lrrosa/retrosc-pong/docs/schematic.md

# Esquemático

Diagramas por **bloco funcional** (SVG), com as referências (R1, C2, J4…) que
aparecem na [lista de materiais](bom.md) e na serigrafia da placa.

> **Só quer montar?** A **PCB já está pronta** em [kicad/](../kicad/README.md)
> — baixe o ZIP de gerbers e mande fabricar. Este documento serve para
> entender cada bloco, montar em placa universal, ou modificar o projeto.

**Esquemático completo em uma folha** (gerado do KiCad, com todas as
referências e valores):
[PDF da variante oficial](retrosc-pong-esquematico.pdf) ·
[PDF da variante roxa de 1 botão](retrosc-pong-yd-esquematico.pdf) ·
[SVG](images/kicad/retrosc-pong.svg)

Mapa de pinos usados

> ⚠️ **Os números de pino deste documento são as posições do Pico oficial**
> (valem também para a YD-RP2040 de 3 botões). A **roxa de 1 botão** usa
> outras posições — confira em [pinout.md](pinout.md) antes de ligar os fios.
> Coincidem nas três: **p36** (3V3), **p38** (GND), **p39** (VSYS/VIN) e
> **p40** (+5 V). Mudam, entre outros: GP16/17/18, GP22, GP26/27 e o **AGND**
> (p33 no Pico, **p29** na roxa).

## DAC de vídeo composto (2 resistores)

DAC de vídeo composto de 2 resistores

Combina os 2 pinos GPIO num sinal de 3 níveis lido pela TV:

| GP16 (SYNC) | GP17 (VIDEO) | Tensão na TV (75 Ω carga) | Significado |
| :---: | :---: | :---: | --- |
| 0 | 0 | 0,00 V | Sync tip |
| 1 | 0 | ~0,37 V | Black (blanking) |
| 1 | 1 | ~1,00 V | White |
| 0 | 1 | (não usado) | - |

Cálculo (Thevenin, 3,3 V, R1=470, R2=270, term=75):

```
G = 1/470 + 1/270 + 1/75 = 0,01916 S
V_black = (3.3/470) / G = 0,366 V
V_white = (3.3/470 + 3.3/270) / G = 1,004 V
```

> **Por que 270 Ω (e não 220 Ω)?** Com 220 Ω o branco fica em ~1,10 V — um
> pouco "quente" acima do 1,00 V padrão. Com 270 Ω o branco cai exatamente em
> ~1,00 V; **testado na TV real, a imagem fica visivelmente melhor**. (1 kΩ +
> 470 Ω também funciona, mas o branco despenca para ~0,63 V — imagem escura.)

### Impedância de saída do GPIO (drive strength)

O cálculo acima assume uma fonte ideal de 3,3 V. Na prática, cada pino GPIO do
RP2040 tem uma impedância de saída em série que se soma a R1/R2 e **abaixa**
os níveis (o branco fica abaixo do calculado). No default (drive de 4 mA) essa
impedância é de ~40–50 Ω; o projeto [obstruse/pico-composite8](https://github.com/obstruse/pico-composite8)
mediu ~40 Ω e teve que compensar nos resistores do seu DAC R2R de 8 bits.

No nosso DAC de 3 níveis isso é menos crítico (a TV tolera bem a faixa), mas
em `src/ntsc.c` configuramos os pinos de vídeo para **drive de 12 mA com slew
rate rápido**, o que reduz a impedância de saída, aproxima os níveis do
calculado e deixa preto/branco mais consistentes:

```c
gpio_set_drive_strength(NTSC_SYNC_PIN,  GPIO_DRIVE_STRENGTH_12MA);
gpio_set_drive_strength(NTSC_VIDEO_PIN, GPIO_DRIVE_STRENGTH_12MA);
gpio_set_slew_rate(NTSC_SYNC_PIN,  GPIO_SLEW_RATE_FAST);
gpio_set_slew_rate(NTSC_VIDEO_PIN, GPIO_SLEW_RATE_FAST);
```

> O próprio **R2 = 270 Ω saiu dessa calibração**: partimos de 220 Ω (branco
> teórico 1,10 V) e o teste na TV real mostrou imagem melhor com 270 Ω
> (branco ~1,00 V). Se quiser refinar mais, meça o branco com a TV conectada
> (carga de 75 Ω) e ajuste R2 até ~1,0 V.

O datasheet do RP2040 (seção 5.5.3.5) confirma essa abordagem: "quanto maior o
drive strength, mais próxima a tensão de saída fica de IOVDD para uma dada
corrente". Dois números úteis dele para este DAC:

- **Margem de corrente:** o limite do banco de IO é `I_IOVDD_MAX = 50 mA`. No
  pior caso (branco, os dois pinos em '1') o DAC puxa ~8,5 mA no pino de vídeo
  (270 Ω) + ~5 mA no de sync (470 Ω) = **~13 mA**. Folga enorme; sem risco. O
  `VOH` mínimo a 3,3 V é 2,62 V já na corrente nominal, e puxamos bem menos.
- **Decoupling de IOVDD:** o datasheet pede 100 nF perto de cada pino IOVDD.
  Na **placa Pico isso já está pronto** — só importa se você fizer uma PCB com
  o **RP2040 cru** (sem módulo), onde esses capacitores precisam ser incluídos.

## Áudio (PWM filtrado + amplificador)

Áudio: filtro RC, divisor de linha e entradas do PAM8403

- **R3 = 1 kΩ + C1 = 100 nF**: filtro RC passa-baixa (fc ≈ 1,6 kHz). Remove
  componentes do PWM, deixando passar os beeps do Pong (até ~500 Hz). O pé do
  **C1 vai ao GND do áudio (p38)** — o mesmo terra do R5 e do power−/G do amp.
- **C2 = 1 µF (eletrolítico, polarizado)**: acoplamento DC. O **+ fica do lado
  do GP18** (saída do filtro R3/C1) — é o lado com ~1,65 V DC do PWM, enquanto
  o outro é puxado a ~0 V pelo R5. **Não é opcional** se o módulo tiver chave
  liga/desliga no pot de volume: com o amp desligado e sem o C2, o PWM do GP18
  injeta corrente pelo diodo de proteção da entrada do chip ("back-powering")
  e o ruído resultante no terra chega a disparar a detecção de movimento dos
  potenciômetros (sintoma real: o jogo "pulava" a tela de attract sozinho).
- **R4 = 10 kΩ + R5 = 1 kΩ: o "divisor de linha"** — é o que gera a saída
  **LINHA** para a TV. Depois do C2 o sinal tem ~2 Vpp (forte demais para uma
  entrada de áudio, que espera ~0,2–0,5 Vpp), então R4 vai em **série** e R5
  do nó para o **GND**: o sinal cai para ~0,2 Vpp (2 V × 1/(10+1)).
  **A saída LINHA é a junção dos dois** (fim do R4 = topo do R5) — é esse nó
  que vai para o pino 1 da chave A/B. **Na PCB ele já está roteado até o
  header J4, pino 3** (marcado `LINHA` na serigrafia): não é preciso soldar
  nada nos resistores, basta ligar o fio da chave nesse pino do J4.
- **2× 1 kΩ (R6 e R7) depois do C2, um para cada entrada (L e R)**: alimenta
  os dois canais do PAM8403 com o sinal mono e isola uma entrada da outra. A carga
  resultante (~5,5 kΩ) causa perda de ~15% no nível — irrelevante. Nenhuma
  entrada fica aberta (entrada flutuando = chiado no canal sem uso).

Amplificador sugerido: **PAM8403** (módulo barato, 3 W). Saída direta para
alto-falante de 4–8 Ω (3 W). Ajustar potenciômetro de volume do módulo, ou
adicionar um trimpot de 10 kΩ entre o filtro e a entrada do amp. **Deixe o
amp sempre alimentado** — não use a chave do pot de volume para cortar o 5 V
(ver nota do C2 acima).

> ⚠️ **As saídas de alto-falante do PAM8403 NÃO têm terra (BTL).** Cada canal
> é uma ponte com os dois terminais ativos; o "−" da saída **não é GND**.
> **Nunca** ligue Lout−/Rout− ao terra (do vídeo ou qualquer outro), **nunca**
> junte Lout− com Rout−, e não conecte as saídas a fone/linha de outro
> aparelho — isso curto-circuita uma saída chaveada e pode queimar o chip.
> Cada alto-falante liga apenas no par +/− do seu canal, com par trançado
> próprio. Com um alto-falante só, use um canal e deixe o outro par
> desconectado (saída sem carga é seguro). Os únicos terras verdadeiros do
> módulo são **power −** e o **G** da entrada — esses sim seguem a estrela.

Alternativa minimalista: alto-falante de PC (8 Ω) direto via capacitor de
acoplamento de 10 µF — volume baixo, mas funciona.

### Chave A/B — RCAs de áudio: linha p/ TV ou saídas do amp

O gabinete tem **dois RCA fêmea de áudio** e uma chave escolhe o que eles
carregam:

- **Modo A — TV:** os RCAs carregam **nível de linha** referenciado ao GND —
  plugue direto na entrada de áudio da TV. Saída de linha é referenciada ao
  terra **por projeto**, então o terra comum interno da TV deixa de ser
  problema. Volume baixo? Troque o 10 kΩ do divisor por 4,7 kΩ (~0,45 Vpp).
  Passe o cabo de áudio junto do de vídeo para minimizar o laço de terra.
- **Modo B — amp:** os RCAs carregam as **saídas BTL** do PAM8403 (+ no
  centro, − no shield) para **caixas passivas** plugadas neles.

**Não há chave no caminho de sinal:** o divisor de linha (10 kΩ + 1 kΩ,
~0,2 Vpp) e as entradas do amp ficam sempre conectados — por isso as entradas
do PAM8403 nunca flutuam e não é preciso resistor de referência extra. No modo
A o amp amplifica "para o nada" (saída aberta é seguro em classe-D); se
preferir, desligue-o no interruptor do volume — o C2 doma o back-powering.

> ⚠️ **Dois cuidados obrigatórios (valem para as duas variantes):** (1) os
> **RCAs devem ser isolados do painel** se ele for metálico — no modo B o
> shield é uma saída ativa (Lout−/Rout−), e encostar num chassi aterrado
> recria o curto BTL. (2) **No modo B, nunca plugue o cabo da TV nos RCAs** —
> dentro da TV os shields de todos os RCAs são o mesmo terra e o curto se
> fecha "por dentro" (foi um sintoma real: perda total de sincronismo com o
> volume ligado; o multímetro na bancada não enxerga porque a junção só existe
> com os cabos plugados). **Etiquete a chave**: som na TV é só no modo A.

#### Padrão — chave DPDT (2 polos, mono)

Chave DPDT de 2 polos nos RCAs: vista de baixo e ligações

**O áudio do Pong é mono** (um único beep no GP18), então estéreo não agrega
nada — o A/B sai com apenas **2 polos**, numa **DPDT** (bem mais fácil de
achar; uma chave seletora de tensão de 6 pinos serve). Ligue os **dois RCAs em
paralelo** e comute-os juntos.

Numeração típica da DPDT de 6 pinos (vista de baixo, 2 fileiras de 3 — a
**fileira do meio são os comuns**):

| Pino da chave | Liga em (fiação manual) | Na PCB | Quando |
| :---: | --- | :---: | --- |
| **3** (comum) | **centros** dos RCAs (L e R juntos) | J4 **p1** | sempre |
| 1 | LINHA (junção R4/R5) | J4 **p3** | posição **A** |
| 5 | Lout+ do PAM8403 | J4 **p5** | posição **B** |
| **4** (comum) | **shields** dos RCAs (L e R juntos) | J4 **p2** | sempre |
| 2 | GND do áudio (p38) | J4 **p4** | posição **A** |
| 6 | Lout− do PAM8403 | J4 **p6** | posição **B** |

> **Na PCB é só ligar 6 fios da chave ao header J4** — a serigrafia traz a
> função de cada pino (RCA_C, RCA_S, LINHA, GND, LOUT+, LOUT−). Os RCAs, o
> divisor e o amp já estão ligados no cobre.

> **Que GND é esse?** "Estrela" é o **jeito de passar os fios**, não um pino:
> cada bloco leva o seu próprio fio até um pino GND do Pico (ver
> [Aterramento em estrela](#alimentação)). O retorno do áudio de linha
> pertence ao bloco de áudio, então vai no **pino 38**, junto do power − do
> amp — que é onde o resistor de baixo do divisor (o de 1 kΩ) também aterra.
> **Não use o AGND** (p33 no Pico, p29 na roxa): ele é exclusivo dos pots; jogar o
> retorno de áudio nele injeta o sinal justamente na referência que o ADC usa.

- Só o canal **Lout** é usado; **Rout fica livre** (não ligue em nada).
- **Modo A:** os dois RCAs mandam o mesmo mono para a TV — plugue em L, em R,
  ou nos dois.
- **Modo B:** plugue **apenas UMA caixa passiva**. Duas em paralelo caem para
  ~2 Ω e forçam o amp.

> ⚠️ **"6 pinos" ≠ "6 polos".** Uma chave com 6 terminais em 2 fileiras de 3 é
> uma **DPDT**: 2 polos × (1 comum + 2 posições). Um 6PDT de verdade teria 18
> terminais. Corrente não é problema: 3 A / 250 V é folga enorme para sinal de
> áudio.
>
> **Meça antes de soldar** (a numeração acima é a típica, mas confirme na sua):
> 1. **Comuns:** com a chave numa posição, o comum é o pino que dá continuidade
>    com **um** dos vizinhos e, ao virar a alavanca, passa a dar com **o outro**
>    (normalmente a fileira do meio: 3 e 4).
> 2. **Independência:** os dois comuns (3 e 4) **não podem ter continuidade
>    entre si** em nenhuma posição — chaves seletoras de tensão às vezes vêm com
>    eles pontados internamente, e nesse caso a chave **não serve** (aterraria
>    o Lout−).
> 3. **Pares:** confirme que 3 fecha com 1 numa posição e com 5 na outra; e que
>    4 fecha com 2 e 6 nas mesmas posições (3+1 e 4+2 têm que fechar **juntos**
>    — é o "ganged").

#### Opcional — chave 4PDT (4 polos, estéreo)

Chave 4PDT de 4 polos nos RCAs: vista de baixo e ligações

> ⚠️ **A PCB do repositório implementa só a variante mono (DPDT)**: os dois
> RCAs de áudio estão em paralelo no cobre e o header J4 tem 6 vias. A 4PDT
> abaixo é para montagem **manual**, com os RCAs cabeados separadamente.

Só vale a pena se você quiser os **dois jacks RCA independentes** — por
exemplo, duas caixas passivas distintas no modo B. Com 4 polos, centro e
shield de cada RCA são comutados separadamente e os dois canais do amp são
aproveitados.

Numeração típica da 4PDT de 12 pinos (vista de baixo, 4 colunas × 3 fileiras —
cada **coluna é um polo** e a **fileira do meio (5–8) são os comuns**):

| Pino | Liga em | Quando |
| :---: | --- | --- |
| **5** (comum) | centro do **RCA-L** | sempre |
| 1 | LINHA — junção R4/R5 (J4 p3) | posição **A** |
| 9 | Lout+ do PAM8403 | posição **B** |
| **6** (comum) | shield do **RCA-L** | sempre |
| 2 | GND do áudio (pino 38) | posição **A** |
| 10 | Lout− do PAM8403 | posição **B** |
| **7** (comum) | centro do **RCA-R** | sempre |
| 3 | LINHA — junção R4/R5 (J4 p3) | posição **A** |
| 11 | Rout+ do PAM8403 | posição **B** |
| **8** (comum) | shield do **RCA-R** | sempre |
| 4 | GND do áudio (pino 38) | posição **A** |
| 12 | Rout− do PAM8403 | posição **B** |

- A numeração acima é a típica, mas **varia por fabricante** — confirme com o
  mesmo **roteiro de 3 medições** da DPDT (acima), agora com 4 comuns: nenhum
  deles pode ter continuidade com outro.

## Potenciômetros

Ligação do potenciômetro ao ADC

- **Linear** (tipo B / "L"). Logarítmico (tipo A) também funciona mas o
  movimento fica não-uniforme.
- O capacitor de 100 nF entre wiper e GND reduz ruído do ADC.
- **Onde montar o 100 nF: na placa, junto ao pino do ADC (GP26/GP27) — não no
  potenciômetro.** Ele faz duas coisas e ambas pedem proximidade do pino: (1)
  serve de reservatório de carga para o sample-and-hold do ADC (só funciona com
  o cap colado no pino, sem cabo no meio); (2) drena para o terra o ruído que o
  fio do wiper (alta impedância, ~2,5 kΩ) captou ao longo de todo o percurso,
  **antes** de entrar no chip. A frequência de corte (~640 Hz) é a mesma
  independente da posição, então não se perde filtragem ao montar na placa.
- **Cabeamento do gabinete:** o fio do wiper é o ponto sensível. Mantenha-o
  curto, roteie longe do amp de áudio / DAC de vídeo / fonte, e use par trançado
  (wiper + GND) ou cabo blindado se passar de ~30–40 cm. Em gabinete muito
  ruidoso dá para adicionar um segundo 100 nF no próprio pot (não atrapalha),
  mas não é necessário.
- **Por que 10 kΩ (e não 5 kΩ)?** Para o ADC do RP2040 dá no mesmo: o
  datasheet (seção 4.9.2) diz que a entrada tem impedância efetiva **> 100 kΩ**
  e que para sinais DC **não há necessidade de buffer**. A impedância de saída
  de um pot é no máximo `R/4` (≈ 2,5 kΩ no 10 kΩ), desprezível frente a 100 kΩ.
  Escolhemos 10 kΩ por convenção e menor consumo (0,33 mA vs 0,66 mA por pot),
  não por exigência do ADC. (Diferente de AVR/Arduino, que pedem fonte < 10 kΩ.)
- **Retorno de terra:** ligue o GND dos pots ao **AGND** (p33 no Pico, p29 na roxa), que
  tem um plano de terra analógico separado sob os GPIO26–29 — leitura mais
  limpa do que usar o GND digital.
- **Supply do ADC mais limpo:** o firmware põe o **GPIO23 em nível alto**, o que
  força o SMPS da placa em modo PWM e reduz o ripple no ADC_VREF (datasheet do
  Pico, seção 4.3). Nada a fazer no hardware.
- **Resolução real:** o ADC tem ENOB ≈ **8,7 bits** (não 12) e picos de DNL em
  4 códigos isolados (errata RP2040-E11); irrelevante aqui, pois mapeamos
  0–4095 → ~168 px e ainda filtramos.
- **Para arcade:** preferencial **CR22E 10 kΩ Linear com stopper** (plástico
  condutivo, 5×10⁶ ciclos, eixo 6 mm com flat, bushing M9). Alternativa
  premium: Sakae FCP22E (~10⁷ ciclos, eixo 6,35 mm, bushing M10). Em ambos o
  **stopper é obrigatório**: sem ele o eixo gira sem batente e o jogador
  encontra uma "zona morta" de 40° acima/abaixo do curso elétrico (que é
  320°). Veja [pecas-do-gabinete.md](pecas-do-gabinete.md).
- Furação do painel: **10,5 mm** (ambos os bushings — M9 do CR22E e M10 do
  FCP22E — pedem furo de Φ10,32 mm).

## Botão SELETOR

Botão SELETOR ligado ao GP22, com o filtro R8/R9/C5 da placa

Push-button momentâneo. **Do painel saem só 2 fios: botão e GND**, que chegam
ao header **J7** — o botão **não** recebe 3,3 V. Quando aberto, GP22 fica em
3,3 V; quando pressionado, vai a GND e o firmware detecta o flanco de descida.

Entre o J7 e o GP22, porém, **a placa tem um filtro de três componentes**:

| Ref | Valor | Onde | O que faz |
| --- | ----- | ---- | --- |
| **R9** | 220 Ω | em série, J7 p1 → GP22 | limita a corrente de ESD que vem do painel de alumínio |
| **R8** | 4,7 kΩ | GP22 → 3V3 | pull-up externo, em paralelo com o interno (~60 kΩ) |
| **C5** | 100 nF | GP22 → GND, junto ao J7 | integra transitórios e o repique do contato |

**Por que o pull-up interno não basta.** O RP2040 tem pull-up interno (ligado
por software com `gpio_pull_up()`), e em bancada ele resolve. Num gabinete ele
é fraco demais: a ~60 kΩ, uma fuga de 30 kΩ entre o pino e o terra — resíduo
de fluxo de solda, poeira com umidade nos terminais, a isolação do cabo
prensada pelo painel — forma um divisor que para em **1,65 V**, exatamente em
cima do limiar de entrada (~1,6 V), e o jogo passa a ler pressões que ninguém
deu. Com o R8 de 4,7 kΩ em paralelo o nó fica em ~4,4 kΩ, e a **mesma** fuga
de 30 kΩ só consegue baixar o pino para **2,85 V** — longe do limiar.

**O que cada um custa.** O R8 puxa 0,7 mA enquanto o botão está pressionado
(contra 55 µA do pull-up interno sozinho): ainda é nada perto dos ~13 mA do
DAC de vídeo, e só flui enquanto alguém segura o botão. O C5 com o R8 dá uma
constante de tempo de ~0,5 ms na subida e ~22 µs na descida (pelo R9) —
imperceptível para um dedo humano, mas suficiente para o repique do contato e
para os picos acoplados pelo cabo chegarem ao pino já alisados.

O **GND do botão pode ser compartilhado** — por exemplo, o mesmo fio que vai
até o shield do RCA de vídeo. Ele drena microamperes (ver
[Aterramento em estrela](#alimentação)), ao contrário do retorno do amp, que
precisa de fio próprio. Na PCB a questão nem se coloca: o GND é um plano.

> **Na placa**, R9 e C5 ficam **colados no J7** de propósito: é no conector que
> a descarga do painel entra, e é ali que ela tem que morrer, antes de percorrer
> a placa até o módulo. O R8 é só um pull-up DC — fica onde couber.

### Se o SELETOR "se pressiona sozinho"

O firmware filtra o pino em três camadas (8 leituras por frame decididas por
maioria, 3 frames confirmando a mudança e 6 frames de carência depois de cada
borda aceita — ver `input.c`). Isso cobre o ruído do próprio sinal composto e do
PWM do áudio, que é o caso que uma leitura única por frame tomava por pressão.

O que o firmware **não** cobre é o pino viver perto do limiar — é para isso que
existem o R8, o R9 e o C5 descritos acima. **Numa placa do repositório eles já
estão lá**; o roteiro abaixo é para quem montou em **perfboard ou fiação
manual**, ou para quando o sintoma aparece mesmo com o filtro montado.

1. **Desligue o cabo do J7** e deixe o GP22 só com o filtro da placa, com o jogo
   rodando. Se continuar, o ruído entra na placa; se parar, é o cabo, o botão ou
   a fiação do painel.
2. **Monte o filtro, se ele não existir.** Em perfboard, solde os três
   componentes junto do conector do botão: **4,7 kΩ de GP22 para 3V3** (R8),
   **100 nF de GP22 para GND** (C5) e **220 Ω em série** entre o fio do painel e
   o pino (R9). Confira também se os três estão soldados de fato na PCB — é fácil
   pular um resistor que não parece fazer nada.
3. Use **par trançado**: o fio do botão com o seu próprio fio de GND, passando
   longe da saída do amplificador e do cabo de vídeo.
4. **Aterre a chapa de alumínio** ao GND do circuito. Em tempo seco, a descarga
   de quem encosta no painel acopla direto no fio do botão — o R9 segura a
   corrente, mas não substitui aterrar a chapa.
5. **Procure a fuga.** Com o cabo desligado e a placa sem alimentação, meça a
   resistência entre o pino do J7 e o GND: qualquer coisa abaixo de ~1 MΩ é
   resíduo de fluxo ou sujeira. Álcool isopropílico e escova resolvem.

## Alimentação

- USB do Pico (5 V): suficiente para o RP2040 e os 2 potenciômetros.
- O PAM8403 precisa de 5 V — pode ser pegado em **VBUS** (pino 40) do Pico.
- Se usar uma fonte externa, ligue em **VSYS** (pino 39) e o RP2040 regula
  para 3,3 V. NÃO ligue 5 V em 3V3 OUT.
- **Aterramento em ESTRELA (importante!):** todos os GND são a mesma rede,
  mas cada bloco deve ter o **seu próprio fio** até um pino GND do Pico — os
  fios só se encontram no Pico, nunca encadeados um no outro:
  - RCA shield (vídeo) → um **GND ao lado de GP16/GP17** (Pico **p23**;
    na roxa o 23 é GP20 — use o **p15**, o GND mais próximo dos dois);
  - PAM8403 power − (retorno do alto-falante) → **GND p38** (é GND nas três);
  - G da entrada de áudio → junto do power − (no módulo é o mesmo plano);
  - potenciômetros → **AGND** (Pico **p33**; roxa **p29**) — só eles;
  - filtro e divisor (**C1** e **R5**) → junto do bloco de áudio, **p38**;
  - retorno do áudio de linha (shield dos RCAs no modo A) → junto do
    bloco de áudio, **p38**;
  - botão SELETOR → **qualquer GND, inclusive o mesmo fio do vídeo**. É a
    exceção: mesmo com o pull-up externo de 4,7 kΩ (R8) ele drena **~0,75 mA**,
    e apenas enquanto pressionado — ainda 17× menos que o retorno do vídeo
    (~13 mA) e uns 400× menos que os picos do amp, ou seja, não move o
    terra de ninguém. E, como entrada digital, tem mais de 1 V de margem
    até o limiar (~1,6 V), então também não se incomoda com o vídeo.

  "Estrela" é a **topologia dos fios**, não um pino: o centro da estrela é o
  próprio módulo. Todos os pinos GND dele são a mesma rede internamente (no
  Pico: 3, 8, 13, 18, 23, 28 e 38; na roxa: 6, 15, 35 e 38) — o que importa é
  **cada bloco ter o seu fio**, sem encadear um no outro. O **AGND** é a
  exceção: mantenha-o exclusivo dos pots, para o ADC não ler o ruído dos
  outros blocos.

  > Na **PCB** isso já vem resolvido: o plano de terra das duas faces é a
  > estrela (impedância baixa em qualquer caminho), e o AGND é uma rede
  > separada, que só encontra o GND dentro do módulo Pico. A instrução acima
  > vale para montagem em **perfboard/fiação manual**.

  O retorno do alto-falante carrega picos de centenas de mA a cada beep; se
  ele compartilhar o fio do shield do RCA, o terra do vídeo "salta" e a TV
  perde o sincronismo no ritmo dos beeps (sintoma real observado: CRT piscando
  a cada ~2 s na tela de attract — a cadência das rebatidas do demo — e TV
  LED sem conseguir travar).

## Saída para TV

- Cabo composto RCA padrão (geralmente amarelo).
- Conectar o **center** (positivo) na saída do DAC, e o **shield** no GND.
- Funciona em CRTs (com entrada AV/composto) e na maioria das TVs LCD com
  entrada AV preservada. Em PAL-M (Brasil), a maioria das TVs aceita NTSC
  monocromático sem cor sem problema.
