lrrosa/retrosc-pong/docs/images/sim_enter_initials.png

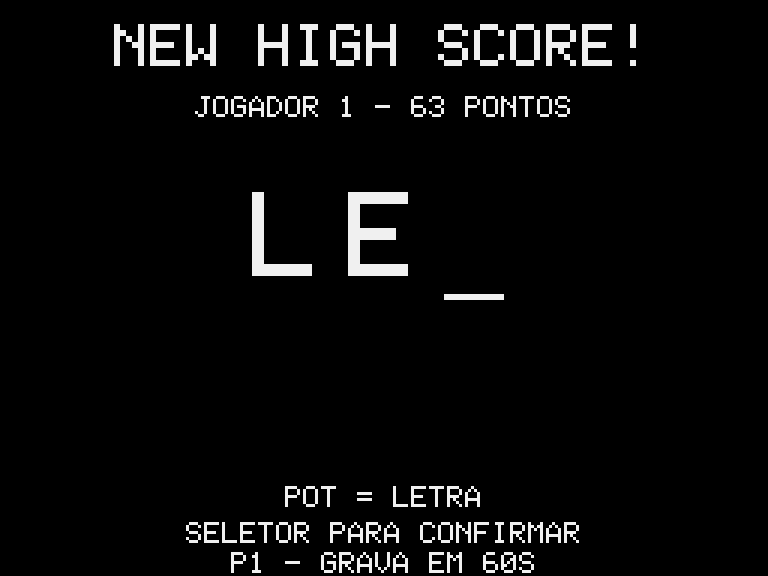
docs/images/sim_enter_initials.png
