lrrosa/retrosc-pong/docs/images/sim_game_over.png

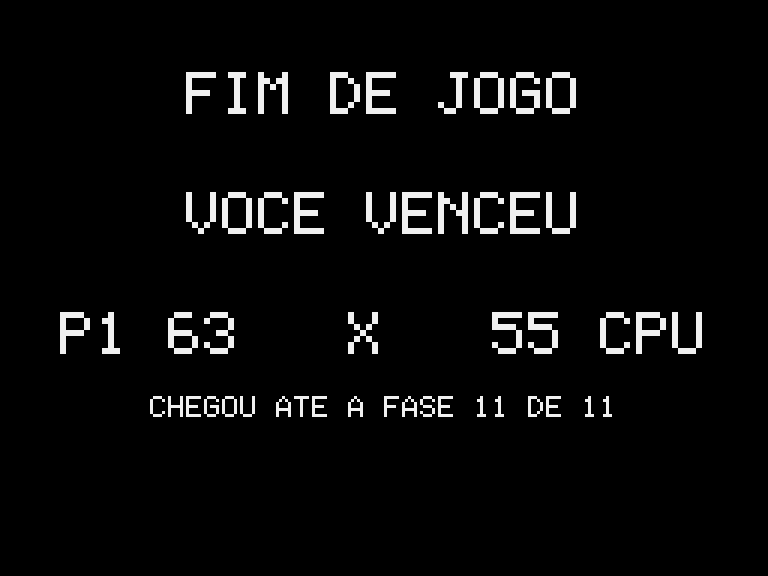
docs/images/sim_game_over.png
