lrrosa/retrosc-pong/docs/images/sim_highscores.png

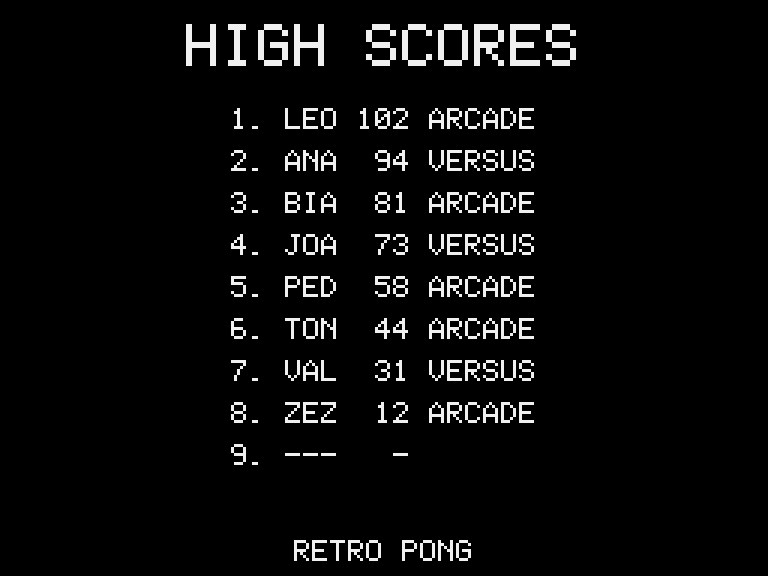
docs/images/sim_highscores.png
