lrrosa/retrosc-pong/docs/images/sim_menu.png

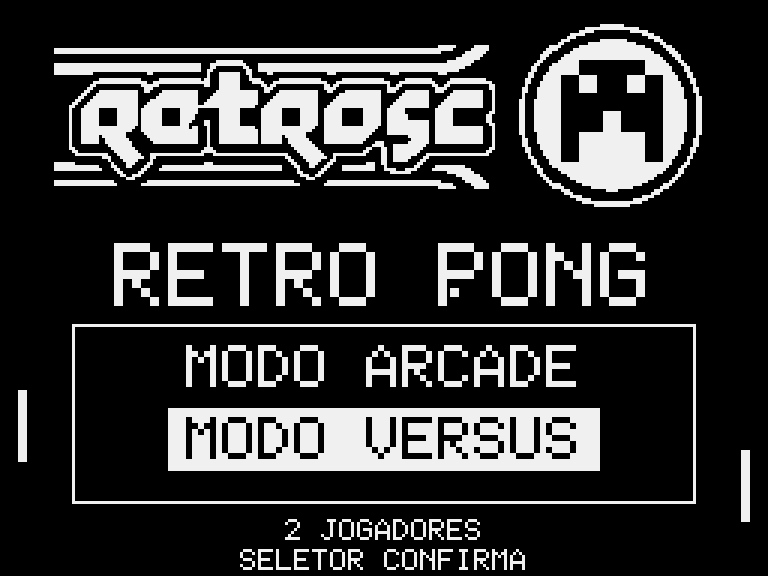
docs/images/sim_menu.png
