lrrosa/retrosc-pong/docs/images/sim_phase_intro.png

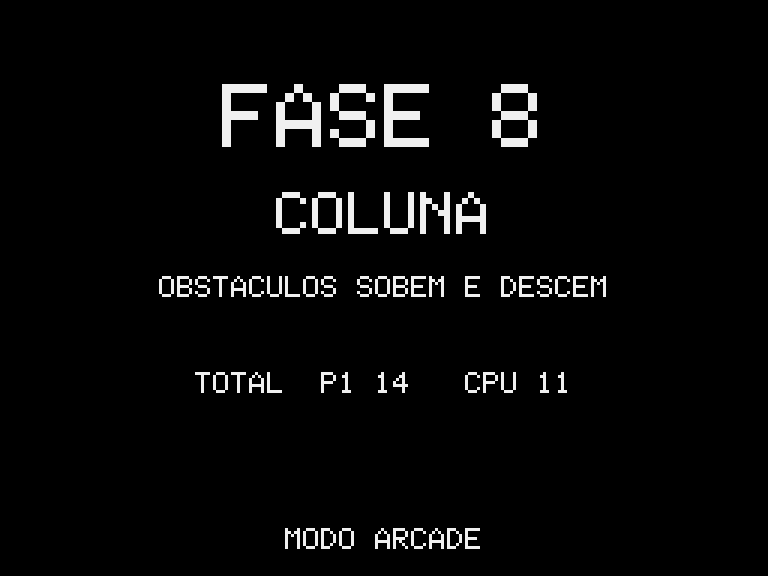
docs/images/sim_phase_intro.png
