lrrosa/retrosc-pong/docs/images/sim_play_muralha.png

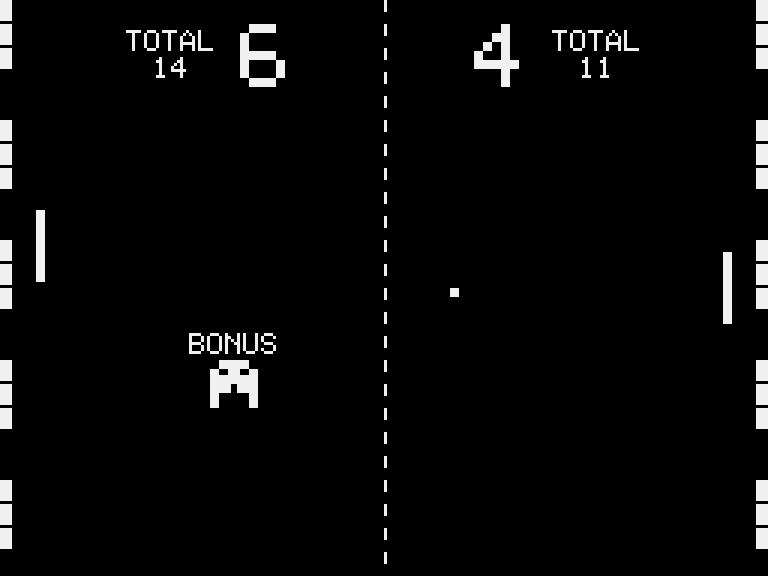
docs/images/sim_play_muralha.png
