lrrosa/retrosc-pong/docs/images/sim_play_pebolim.png

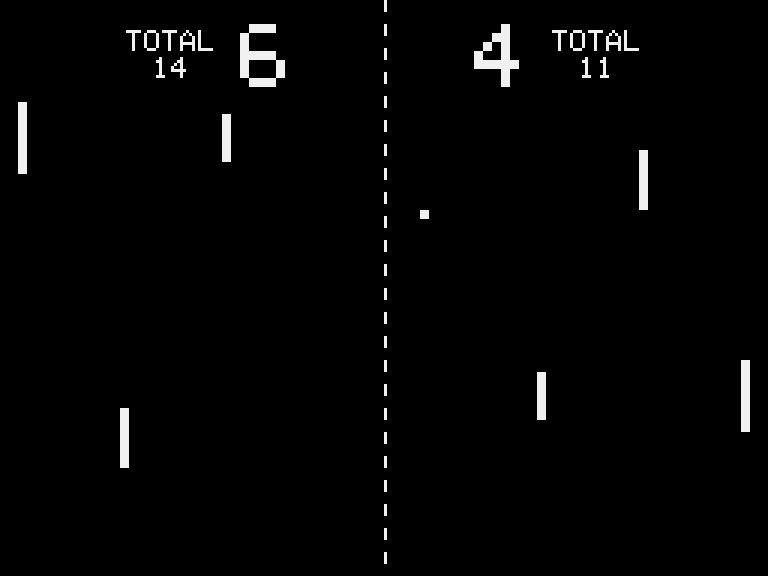
docs/images/sim_play_pebolim.png
