lrrosa/retrosc-pong/docs/retrosc-pong-esquematico.pdf

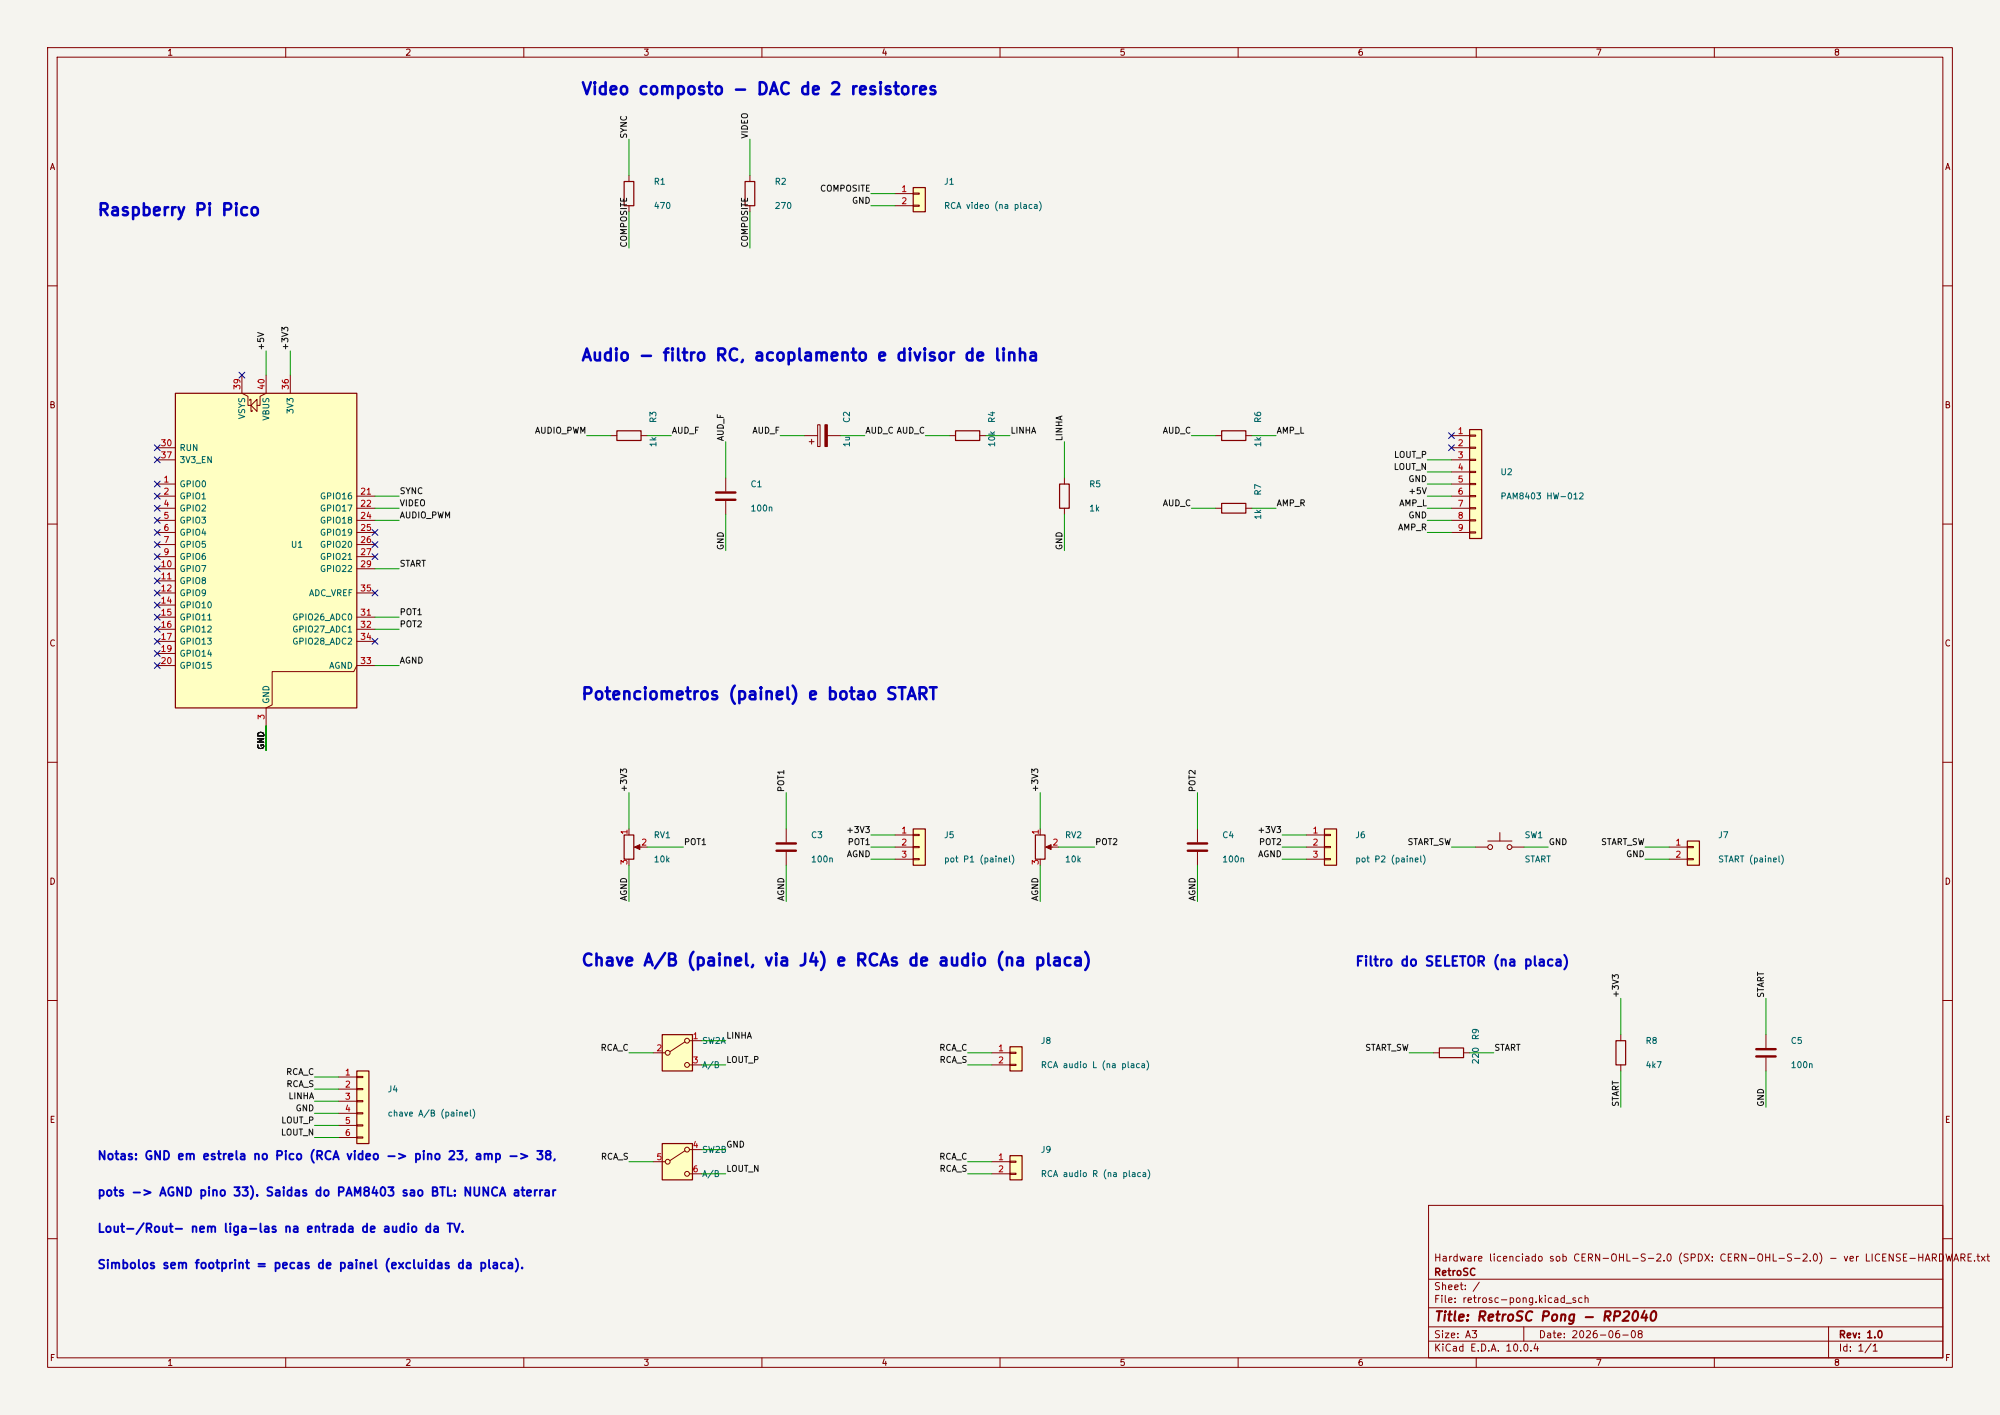
[picture p18: page 1]

Video composto - DAC de 2 resistores

START POT1 Raspberry Pi Pico

Audio - filtro RC, acoplamento e divisor de linha

Hardware licenciado sob CERN-OHL-S-2.0 (SPDX: CERN-OHL-S-2.0) - ver LICENSE-HARDWARE.txt C2 1u 1

Potenciometros (painel) e botao START

Chave A/B (painel, via J4) e RCAs de audio (na placa)

Filtro do SELETOR (na placa)

Notas: GND em estrela no Pico (RCA video -> pino 23, amp -> 38,

pots -> AGND pino 33). Saidas do PAM8403 sao BTL: NUNCA aterrar

Lout-/Rout- nem liga-las na entrada de audio da TV.

Simbolos sem footprint = pecas de painel (excluidas da placa).

Size: A3 | Rev: 1.0 | F Date: 2026-06-08
KiCad E.D.A. 10.0.4 | Id: 1/1
