lrrosa/retrosc-pong/docs/retrosc-pong-yd-esquematico.pdf

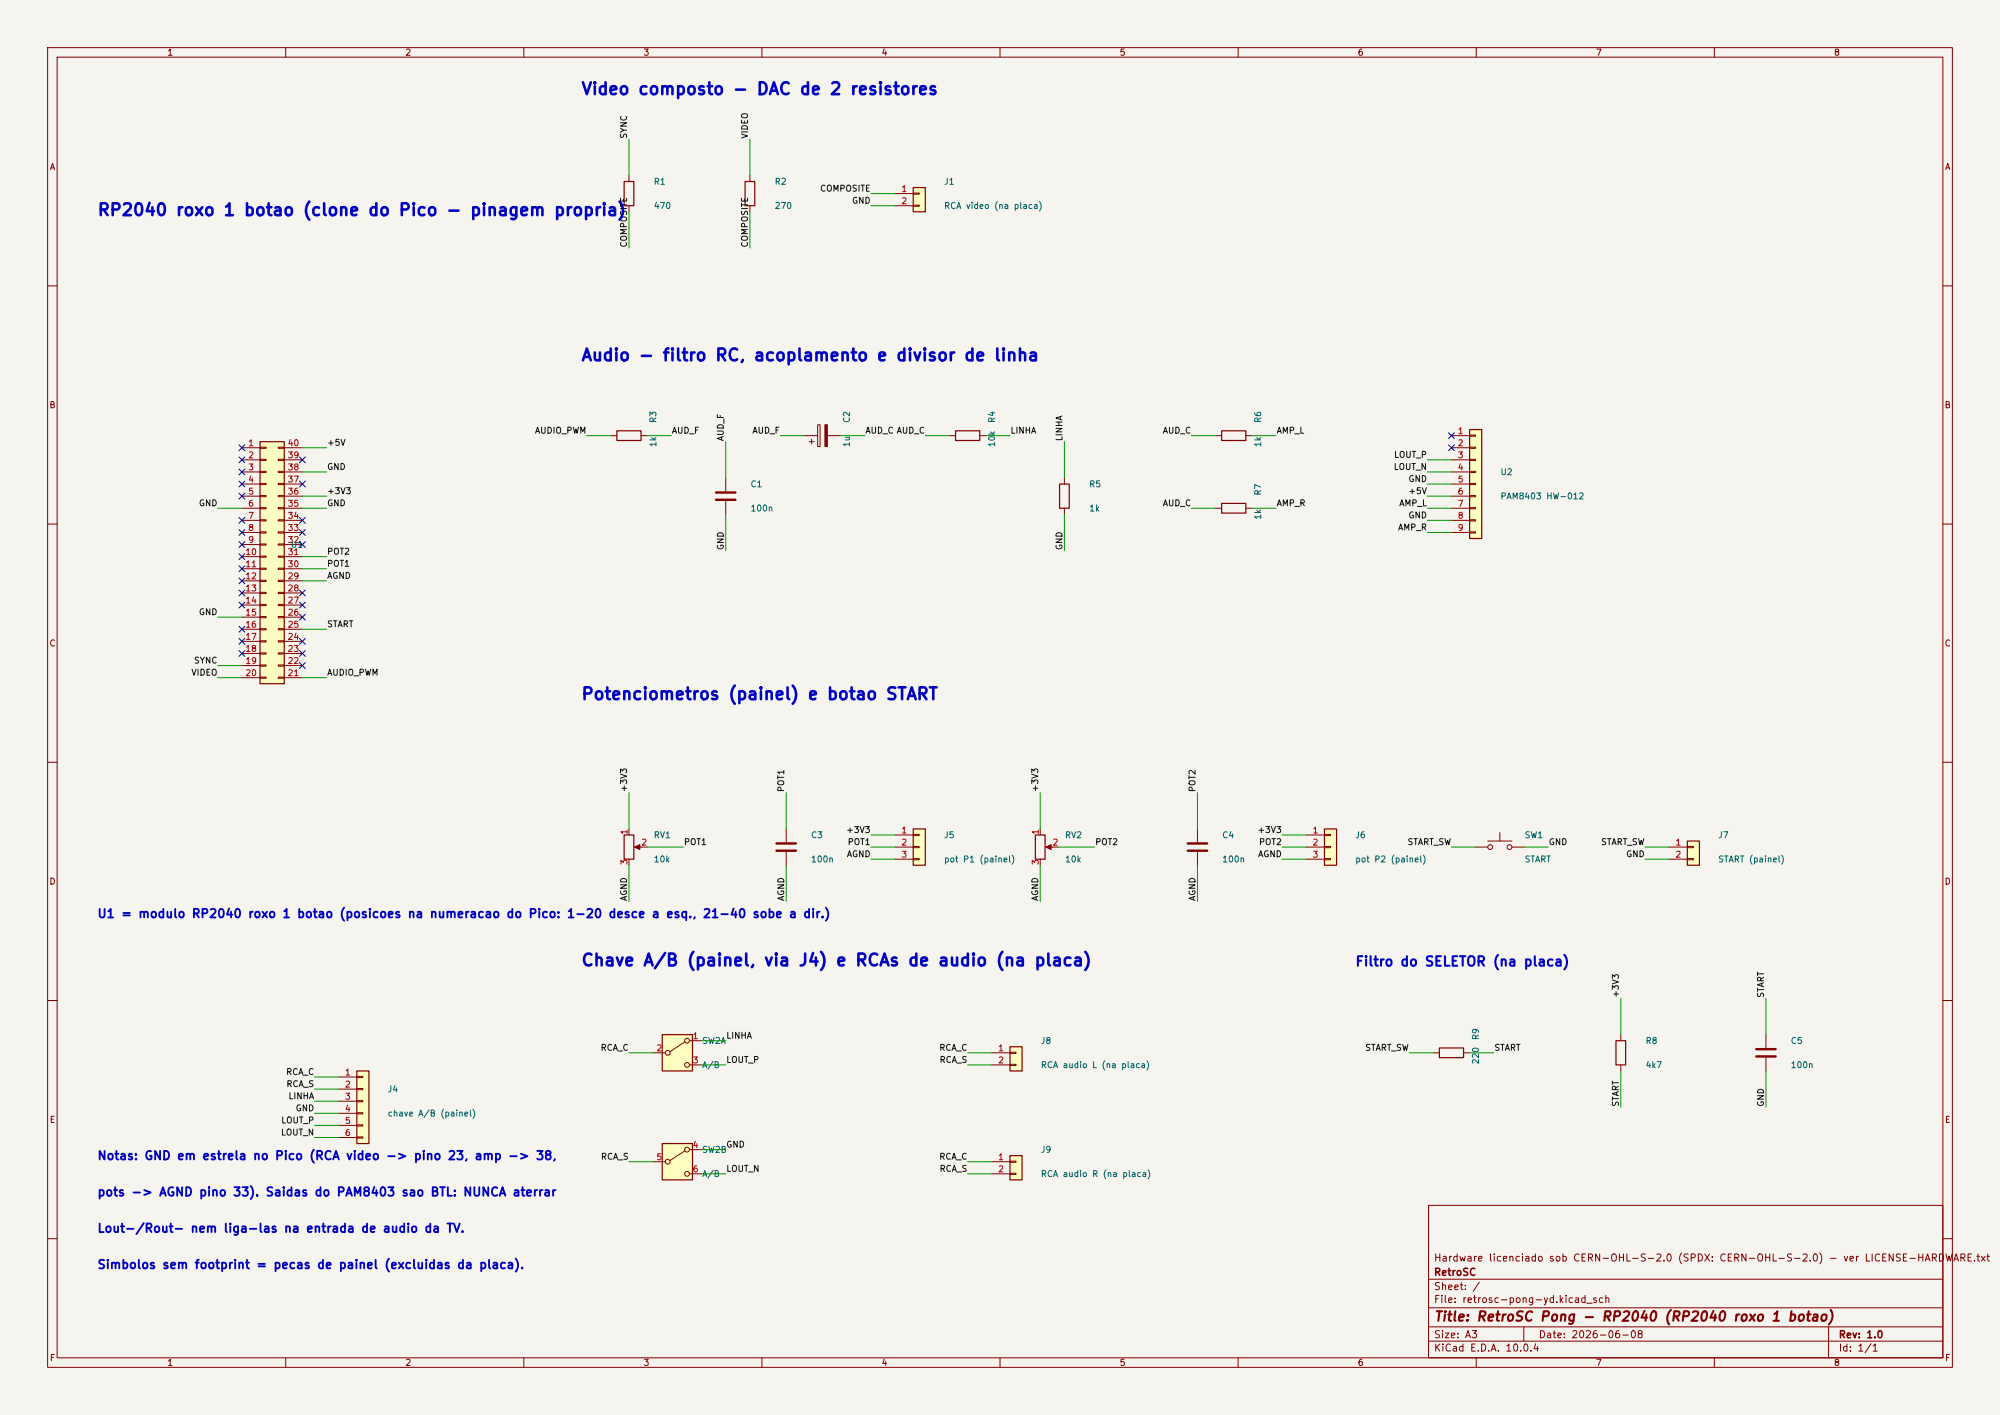
[picture p19: page 1]

Video composto - DAC de 2 resistores

RP2040 roxo 1 botao (clone do Pico - pinagem propria)

Audio - filtro RC, acoplamento e divisor de linha

Potenciometros (painel) e botao START

U1 = modulo RP2040 roxo 1 botao (posicoes na numeracao do Pico: 1-20 desce a esq., 21-40 sobe a dir.)

Chave A/B (painel, via J4) e RCAs de audio (na placa)

Filtro do SELETOR (na placa)

Notas: GND em estrela no Pico (RCA video -> pino 23, amp -> 38,

pots -> AGND pino 33). Saidas do PAM8403 sao BTL: NUNCA aterrar

Lout-/Rout- nem liga-las na entrada de audio da TV.

Hardware licenciado sob CERN-OHL-S-2.0 (SPDX: CERN-OHL-S-2.0) - ver LICENSE-HARDWARE.txt
RetroSC
Sheet: /
File: retrosc-pong-yd.kicad_sch
Title: RetroSC Pong - RP2040 (RP2040 roxo 1 botao)

Simbolos sem footprint = pecas de painel (excluidas da placa).

Size: A3 | Rev: 1.0
KiCad E.D.A. 10.0.4 | Id: 1/1 | F Date: 2026-06-08
