lrrosa/retrosc-pong/kicad/retrosc-pong.kicad_pcb

## KiCad design kicad/retrosc-pong.kicad_pcb (2026-11-03)

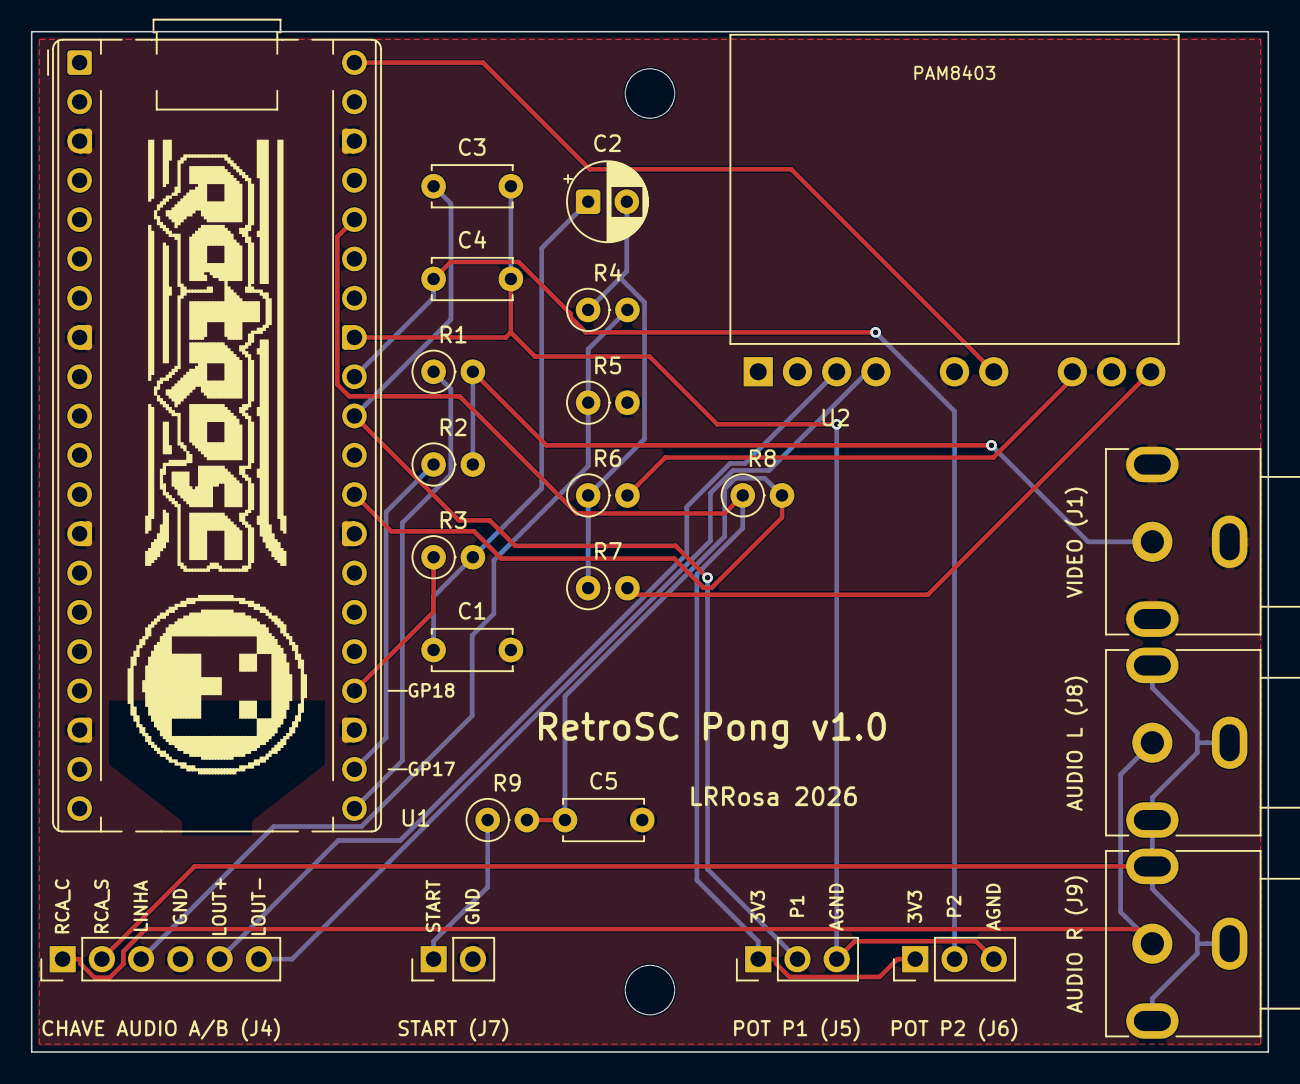
[picture p20: board retrosc-pong.kicad_pcb from above]

Board: 2 copper layers, 80.0 x 66.0 mm, 25 parts (0 on the bottom side), 21 nets.

Parts:
C1, C3, C4, C5: 100n; C_Disc_D5.0mm_W2.5mm_P5.00mm
C2: 1u; CP_Radial_D5.0mm_P2.50mm
H1, H2: MountingHole_3.2mm_M3
J1: RCA video (na placa); RCA_Jack_THT_Panel
J4: chave A/B (painel); PinHeader_1x06_P2.54mm_Vertical
J5: pot P1 (painel); PinHeader_1x03_P2.54mm_Vertical
J6: pot P2 (painel); PinHeader_1x03_P2.54mm_Vertical
J7: START (painel); PinHeader_1x02_P2.54mm_Vertical
J8: RCA audio L (na placa); RCA_Jack_THT_Panel
J9: RCA audio R (na placa); RCA_Jack_THT_Panel
R1: 470; R_Axial_DIN0207_L6.3mm_D2.5mm_P2.54mm_Vertical
R2: 270; R_Axial_DIN0207_L6.3mm_D2.5mm_P2.54mm_Vertical
R3, R5, R6, R7: 1k; R_Axial_DIN0207_L6.3mm_D2.5mm_P2.54mm_Vertical
R4: 10k; R_Axial_DIN0207_L6.3mm_D2.5mm_P2.54mm_Vertical
R8: 4k7; R_Axial_DIN0207_L6.3mm_D2.5mm_P2.54mm_Vertical
R9: 220; R_Axial_DIN0207_L6.3mm_D2.5mm_P2.54mm_Vertical
U1: RaspberryPi_Pico; RaspberryPi_Pico_Common_THT
U2: PAM8403 HW-012; PAM8403_HW-012

Connections:
+3V3: J5.1, J6.1, R8.1, U1.36
+5V: U1.40, U2.6
AGND: C3.2, C4.2, J5.3, J6.3, U1.33
AMP_L: R6.2, U2.7
AMP_R: R7.2, U2.9
AUDIO_PWM: R3.1, U1.24
AUD_C: C2.2, R4.1, R6.1, R7.1
AUD_F: C1.1, C2.1, R3.2
COMPOSITE: J1.1, R1.2, R2.2
GND: C1.2, C5.2, J1.2, J4.4, J7.2, R5.2, U1.3, U1.8, U1.13, U1.18, U1.23, U1.28, U1.38, U2.5, U2.8
LINHA: J4.3, R4.2, R5.1
LOUT_N: J4.6, U2.4
LOUT_P: J4.5, U2.3
POT1: C3.1, J5.2, U1.31
POT2: C4.1, J6.2, U1.32
RCA_C: J4.1, J8.1, J9.1
RCA_S: J4.2, J8.2, J9.2
START: C5.1, R8.2, R9.2, U1.29
START_SW: J7.1, R9.1
SYNC: R1.1, U1.21
VIDEO: R2.1, U1.22
