lrrosa/retrosc-pong/(commit log)

2026-09-07 jogo: saque da fase da nave saindo de dentro da nave
    A bola nascia no centro exato da quadra, que e onde a nave volta a cada
    ponto (x 115-140, y 88-103): quem escolhia o lado nao era a direcao do
    saque e sim o primeiro quique, porque bounce_off() decide a face de
    saida pela direcao da bola. Medido no simulador em 800 saques, 51% deles
    saiam na direcao de quem tinha acabado de pontuar e 99% davam um pulo de
    ~13 px na vertical ao ser empurrada para fora da nave.
    A nave passa a seguir a mesma regra do pinball e da coluna movel: o
    saque sai a 34 px do centro, do lado de quem vai receber, com a meia
    quadra dele inteira pela frente. Nas nove fases de saque horizontal a
    medicao volta zerada.
    Esca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
2026-09-07 jogo: nave revida a bolada; copyright em nome do autor
    A nave da PHASE_NAVE devolve um tiro pelo lado de quem rebateu a bola
    sempre que leva uma bolada. phase_ball_collide() nao conhece o
    last_hitter, entao ela so anota o lado em nave_revide e quem dispara e o
    update_nave(), no mesmo frame -- physics() roda antes de phase_update()
    dentro de frame_play(), e e essa ordem que faz o tiro sair junto com a
    batida. Se ninguem tiver tocado na bola ainda, vale o lado de onde ela
    veio (medido: nenhum caso desde que o saque saiu de dentro da nave).
    O revide reinicia o relogio do tiro periodico, entao conta como o tiro
    da vez em vez de somar em cima do outro: sem isso uma bola teimosa na
    nave viraria u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
2026-09-09 jogo: cinco bonus no mascote e rebote pela travessia
    Acertar o mascote passa a sortear um de cinco premios (bonus_tipo_t) para
    quem rebateu a bola por ultimo, a CPU inclusive. Alem dos 3 pontos que ja
    existiam: raquete aumentada, raquete do rival pela metade, escudo de
    tijolos quebraveis na frente do proprio gol e turbo. Os quatro duram 10 s
    de tempo de jogo e atravessam o ponto -- so o comeco da fase os apaga,
    diferente do encolhimento do tiro da nave, que o phase_round_reset()
    limpa. O nome do premio aparece por 2 s do lado de quem levou: com cinco
    tipos, o total piscando ja nao diz o que aconteceu.
    O turbo tem dois cronometros separados de proposito. A janela de 10 s
    fica em phases.c, ju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
2026-09-10 jogo: rodada de acertos depois dos testes na maquina real
    AUDIO. O divisor do PWM satura em 255, entao com PWM_TOP de 10 bits nenhum tom
    descia de 478 Hz: a rebatida (226 Hz) e a parede (246 Hz) saiam ambas presas
    nesse piso, iguais entre si, e uma parede seguida de rebatida virava um tom so
    -- era esse o "as vezes o som da bola nao sai". Com TOP de 12 bits o piso cai
    para 120 Hz e as notas se separam (rebatida 480, parede 640, tijolo 880, ponto
    150 Hz por 450 ms). O audio_beep() tambem insere um frame de silencio quando
    corta um tom em andamento, para dois eventos seguidos nunca virarem um. O que
    sobrou de "rebatida sem som" na maquina nao era firmware: era a TV de 10
    polegadas, cujos alto-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
2026-09-11 jogo: som do ponto mais curto e recordes centrados em bloco
    Duas coisas que sobraram do teste no gabinete:
    - audio_score() cai de 450 para 300 ms. O ponto continua sendo o unico
    som grave e o mais longo do jogo, com folga sobre os 67 ms da rebatida.
    - a tabela de recordes era desenhada com x fixo em 52, o que deixava o
    bloco fora de centro. Agora o x sai da largura de uma linha cheia
    ("0. XXX 000 ARCADE"): centra o CONJUNTO, nao cada linha, que e o que
    mantem as colunas alinhadas.
    [audio.c, game.c]
2026-09-11 jogo: fase PEBOLIM, tres barras por jogador com a do meio invertida
    Cada jogador passa a ter tres barras em profundidades diferentes, todas
    no mesmo pot: a de tras (goleiro, PADDLE_H), a do meio e a da frente (a
    menor), separadas por PEBOLIM_PASSO. As das pontas seguem a leitura do
    pot; a DO MEIO recebe o curso ESPELHADO (range - pos) -- subir o pot
    desce a barra do meio, e e isso que a fase e. Com o pot no meio do curso
    as tres se alinham, que e a posicao mais fraca.
    Decisoes que sustentam a fase:
    - as tres alturas sao diferentes (24/20/16) de proposito. Iguais, o
    goleiro seria uma copia do atacante na mesma altura e nunca salvaria
    nada que o atacante ja nao tivesse salvado.
    - phase_p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
2026-09-16 jogo: tabela de recordes com 9 lugares em vez de 5
    A tela comporta: uma linha a cada 14 px, de y=36 a y=148, ainda 25 px
    acima do rodape. Conferido no pior caso -- as 9 linhas cheias com o maior
    placar possivel (123, tres letras, VERSUS) ocupam de y=8 a y=186 e de
    x=62 a x=191.
    O numero de entradas muda o TAMANHO do registro gravado na flash, entao
    vai junto com HISCORE_VERSION 4: sem versao nova, uma tabela v3 antiga
    seria lida com o layout novo e so o checksum a pegaria, que e fragil
    demais para confiar. Com a v4 ela e descartada no primeiro boot, como ja
    aconteceu na v3.
    _Static_assert novo em highscores.c: hi_save() grava UMA pagina de flash
    e copia a tabela inteira para um buffer dess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
2026-09-28 Corrige colisoes, controles e retorno ao menu; adiciona testes C
    Divide a fisica em subpassos, normaliza o giro dos obstaculos e evita shifts negativos. Corrige o alcance dos pots, filtra repiques do seletor e reinicializa a demo ao abrir o menu pelos recordes. Mantem o simulador em sincronia e adiciona regressao C com 330 mil frames, UBSan e 2.200 cenarios comparados.
    [check_firmware.py, check_sim.py, config.h, game.c, input.c]
2026-11-03 Endurece o debounce do SELETOR contra ruido do video
    O botao era lido uma vez por frame, sempre na mesma fase do quadro
    (input_poll roda logo depois de ntsc_wait_vsync, que e quando o PIO e o
    DMA reiniciam o frame), entao ruido periodico do sinal composto ou do
    PWM do audio saia identico em todos os frames e o debounce por frames
    passava por cima dele: no gabinete o jogo se comportava como se o
    SELETOR estivesse sendo premido sozinho, com o botao em si bom.
    Agora o estado do pino e decidido por maioria de 8 leituras espacadas de
    71 us -- 1,125 linha de video, de modo que cada leitura cai 1/8 de linha
    adiante da anterior e as 8 cobrem o periodo de linha em fases diferentes
    --, com 3 frames c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
2026-11-03 Leva o filtro do SELETOR para a PCB nas duas variantes
    O pino do botao vinha pendurado so no pull-up interno do RP2040 (~60
    kOhm) e saia da placa por 2 fios ate um painel de aluminio: uma fuga de
    30 kOhm entre ele e o terra -- residuo de fluxo, poeira com umidade,
    isolacao do cabo prensada -- forma um divisor que para em 1,65 V,
    exatamente em cima do limiar, e o jogo le pressoes que ninguem deu. O
    commit anterior endureceu o debounce, que cobre ruido do video e do PWM
    do audio, mas nao cobre um pino que simplesmente vive no limiar. Isso e
    hardware, e ate agora estava escrito em docs/schematic.md como instrucao
    de montagem manual.
    Agora sao tres componentes na propria placa, nas duas variant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
